JamesDavid/cyd-scd41-co2-monitor/(commit log)

2026-05-03 Initial Commit of working files
    [cyd_desk_stand_4.scad]
2026-05-09 v1.6.2: MQTT, auto-brightness, stats screen, multi-device support
    Firmware:
    - MQTT publishing with Home Assistant auto-discovery (configurable
    via /mqtt web form)
    - Auto-brightness mode driven by the on-board LDR with EMA smoothing
    - 24-hour stats screen (min/avg/max, time-in-zone, best/worst hour)
    - Graph cycles between CO2, temperature, and humidity
    - Per-device hostname/AP suffix derived from MAC so multiple units
    do not collide on one network; user-customizable via web form
    - Brightness toggle in Settings header (100/75/50/25/Auto)
    Docs:
    - New CLAUDE.md guide for future Claude Code sessions
    - New scd41.md sensor reference (500ms-after-stop, ASC trap, FRC)
    - README/cyd/user_manual re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
    [cyd_scd41_co2_monitor_portrait.ino]
2026-05-10 Add .gitignore for Arduino build artifacts and Claude local settings
    Excludes the Arduino IDE's build/ output, exported .ino.esp32.bin
    binaries, and Claude Code's per-machine settings.local.json.
2026-06-01 v1.7.0: Aranet Rn radon monitoring over BLE
    Passively sniff an Aranet Rn radon detector's BLE advertisement (Smart
    Home Integration mode, no pairing) and treat radon as a fourth metric
    alongside CO2/temp/RH.
    - BLE: NimBLE active scan (~3s every 60s, non-blocking) parses the
    Aranet manufacturer-data advert (radon Bq/m3, battery, status, name).
    Tracks seen devices by MAC; auto-selects strongest RSSI or a pinned
    MAC. Advert callback (BLE task) only updates the device table; the
    String-touching selection runs on the main task to avoid a race.
    - Display: bottom row reflows to Temp|RH|Radon when fresh (2-col
    fallback when stale), zone-coloured value, low-battery marker, and a
    tap-to-t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
    [partitions.csv]
2026-06-26 Add GitHub Pages web flasher (ESP Web Tools)
    Browser-based USB flasher at docs/ so users can install the firmware
    from Chrome/Edge/Opera without a toolchain.
    - docs/index.html: ESP Web Tools install button + instructions, with the
    partition-change / log-reset and OTA caveats spelled out.
    - docs/manifest.json: ESP32 build, parts at 0x1000/0x8000/0xe000/0x10000.
    - docs/firmware/*.bin: bootloader, partitions, boot_app0, firmware (v1.7.0).
    - .gitignore: explicit !docs/firmware/*.bin so the flasher bins stay
    tracked even if a broad *.bin ignore is added later.
    - README: "Flash it from your browser" section + bin-refresh steps.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
